Nyar-ai/Robot/MDK-ARM/build_log.txt

*** Using Compiler 'V5.06 update 7 (build 960)', folder: 'D:\kail5\ARM\ARMCC\Bin'
Build target 'Robot'
"Robot\Robot.axf" - 0 Error(s), 0 Warning(s).
Build Time Elapsed:  00:00:01
