Nyar-ai/Robot/Robot.ioc

Mcu.UserName=STM32F407VGTx
PA0-WKUP.Signal=S_TIM2_CH1_ETR
PA1.Signal=S_TIM2_CH2
PA10.Signal=USB_OTG_FS_ID
PA11.Signal=USB_OTG_FS_DM
PA12.Signal=USB_OTG_FS_DP
PA13.Signal=SYS_JTMS-SWDIO
PA14.Signal=SYS_JTCK-SWCLK
PA15.Signal=SYS_JTDI
PA2.Signal=S_TIM2_CH3
PA3.Signal=S_TIM2_CH4
PA6.Signal=S_TIM3_CH1
PA9.Signal=USB_OTG_FS_VBUS
PB10.Signal=USART3_TX
PB11.Signal=USART3_RX
PB3.Signal=SYS_JTDO-SWO
PB5.Signal=GPIO_Output
PB6.Signal=USART1_TX
PB7.Signal=USART1_RX
PB8.Signal=I2C1_SCL
PB9.Signal=I2C1_SDA
PC6.Signal=USART6_TX
PC7.Signal=USART6_RX
PC8.Signal=S_TIM8_CH3
PD12.Signal=S_TIM4_CH1
PD4.Signal=GPIO_Output
PD5.Signal=USART2_TX
PD6.Signal=USART2_RX
PD7.Signal=GPIO_Output
PE12.Signal=GPIO_Output
PE13.Signal=GPIO_Output
PE14.Signal=S_TIM1_CH4
PE15.Signal=GPIO_Output
PE5.Signal=S_TIM9_CH1
PH0-OSC_IN.Signal=RCC_OSC_IN
PH1-OSC_OUT.Signal=RCC_OSC_OUT
