Nyar-ai/Robot/MDK-ARM/.eide/eide.yml

version: "4.1"
name: Robot
type: ARM
deviceName: null
packDir: null
srcDirs: []
virtualFolder:
  name: <virtual_root>
  files: []
  folders:
    - name: Application
      files: []
      folders:
        - name: MDK-ARM
          files:
            - path: startup_stm32f407xx.s
          folders: []
        - name: User
          files: []
          folders:
            - name: Core
              files:
                - path: ../Core/Src/main.c
                - path: ../Core/Src/gpio.c
                - path: ../Core/Src/freertos.c
                - path: ../Core/Src/i2c.c
                - path: ../Core/Src/tim.c
                - path: ../Core/Src/usart.c
                - path: ../Core/Src/usb_otg.c
                - path: ../Core/Src/stm32f4xx_it.c
                - path: ../Core/Src/stm32f4xx_hal_msp.c
                - path: ../Core/Src/stm32f4xx_hal_timebase_tim.c
                - path: ../Core/Src/trape.c
                - path: ../Core/Src/mecanum.c
                - path: ../Core/Src/chassis.c
                - path: ../Core/Src/stepper.c
                - path: ../Core/Src/dma.c
                - path: ../Core/Src/mpu6050.c
                - path: ../Core/Src/system_stm32f4xx.c
                - path: ../Core/Src/camera_align.c
                - path: ../Core/Src/clamp.c
                - path: ../Core/Src/servo.c
                - path: ../Core/Src/camera_color.c
                - path: ../Core/Src/cross_detect.c
              folders: []
    - name: Drivers
      files: []
      folders:
        - name: STM32F4xx_HAL_Driver
          files:
            - path: ../Drivers/STM32F4xx_HAL_Driver/Src/stm32f4xx_hal_tim.c
            - path: ../Drivers/STM32F4xx_HAL_Driver/Src/stm32f4xx_hal_tim_ex.c
            - path: ../Drivers/STM32F4xx_HAL_Driver/Src/stm32f4xx_hal_rcc.c
            - path: ../Drivers/STM32F4xx_HAL_Driver/Src/stm32f4xx_hal_rcc_ex.c
            - path: ../Drivers/STM32F4xx_HAL_Driver/Src/stm32f4xx_hal_flash.c
            - path: ../Drivers/STM32F4xx_HAL_Driver/Src/stm32f4xx_hal_flash_ex.c
            - path: ../Drivers/STM32F4xx_HAL_Driver/Src/stm32f4xx_hal_flash_ramfunc.c
            - path: ../Drivers/STM32F4xx_HAL_Driver/Src/stm32f4xx_hal_gpio.c
            - path: ../Drivers/STM32F4xx_HAL_Driver/Src/stm32f4xx_hal_dma_ex.c
            - path: ../Drivers/STM32F4xx_HAL_Driver/Src/stm32f4xx_hal_dma.c
            - path: ../Drivers/STM32F4xx_HAL_Driver/Src/stm32f4xx_hal_pwr.c
            - path: ../Drivers/STM32F4xx_HAL_Driver/Src/stm32f4xx_hal_pwr_ex.c
            - path: ../Drivers/STM32F4xx_HAL_Driver/Src/stm32f4xx_hal_cortex.c
            - path: ../Drivers/STM32F4xx_HAL_Driver/Src/stm32f4xx_hal.c
            - path: ../Drivers/STM32F4xx_HAL_Driver/Src/stm32f4xx_hal_exti.c
            - path: ../Drivers/STM32F4xx_HAL_Driver/Src/stm32f4xx_hal_i2c.c
            - path: ../Drivers/STM32F4xx_HAL_Driver/Src/stm32f4xx_hal_i2c_ex.c
            - path: ../Drivers/STM32F4xx_HAL_Driver/Src/stm32f4xx_hal_uart.c
          folders: []
        - name: CMSIS
          files:
            - path: ../Core/Src/system_stm32f4xx.c
          folders: []
    - name: Middlewares
      files: []
      folders:
        - name: FreeRTOS
          files:
            - path: ../Middlewares/Third_Party/FreeRTOS/Source/croutine.c
            - path: ../Middlewares/Third_Party/FreeRTOS/Source/event_groups.c
            - path: ../Middlewares/Third_Party/FreeRTOS/Source/list.c
            - path: ../Middlewares/Third_Party/FreeRTOS/Source/queue.c
            - path: ../Middlewares/Third_Party/FreeRTOS/Source/stream_buffer.c
            - path: ../Middlewares/Third_Party/FreeRTOS/Source/tasks.c
            - path: ../Middlewares/Third_Party/FreeRTOS/Source/timers.c
            - path: ../Middlewares/Third_Party/FreeRTOS/Source/CMSIS_RTOS_V2/cmsis_os2.c
            - path: ../Middlewares/Third_Party/FreeRTOS/Source/portable/MemMang/heap_4.c
            - path: ../Middlewares/Third_Party/FreeRTOS/Source/portable/RVDS/ARM_CM4F/port.c
          folders: []
dependenceList: []
outDir: build
miscInfo:
  uid: e0cc28da6c254d071c60158790d19ba3
targets:
  Robot:
    cppPreprocessAttrs:
      defineList:
        - USE_HAL_DRIVER
        - STM32F407xx
      incList:
        - ../Core/Inc
        - ../Drivers/STM32F4xx_HAL_Driver/Inc
        - ../Drivers/STM32F4xx_HAL_Driver/Inc/Legacy
        - ../Middlewares/Third_Party/FreeRTOS/Source/include
        - ../Middlewares/Third_Party/FreeRTOS/Source/CMSIS_RTOS_V2
        - ../Middlewares/Third_Party/FreeRTOS/Source/portable/RVDS/ARM_CM4F
        - ../Drivers/CMSIS/Device/ST/STM32F4xx/Include
        - ../Drivers/CMSIS/Include
        - .cmsis/include
        - RTE/_Robot
      libList: []
    excludeList: []
    settings:
      debugger: cortex-debug
    toolchain: AC5
    toolchainConfigMap:
      AC5:
        archExtensions: ""
        cpuType: Cortex-M4
        floatingPointHardware: single
        options:
          version: 4
          afterBuildTasks: []
          asm-compiler:
            defines: []
          beforeBuildTasks: []
          c/cpp-compiler:
            CXX_FLAGS: --diag_suppress=1 --diag_suppress=1295
            C_FLAGS: --diag_suppress=1 --diag_suppress=1295
            c99-mode: true
            one-elf-section-per-function: true
            optimization: level-3
            warnings: all-warnings
          global:
            output-debug-info: enable
            use-microLIB: false
          linker:
            $outputTaskExcludes:
              - .bin
            output-format: elf
            ro-base: ""
            rw-base: ""
            xo-base: ""
        scatterFilePath: ""
        storageLayout:
          RAM:
            - id: 1
              isChecked: false
              mem:
                size: "0x0"
                startAddr: "0x0"
              noInit: false
              tag: RAM
            - id: 2
              isChecked: false
              mem:
                size: "0x0"
                startAddr: "0x0"
              noInit: false
              tag: RAM
            - id: 3
              isChecked: false
              mem:
                size: "0x0"
                startAddr: "0x0"
              noInit: false
              tag: RAM
            - id: 1
              isChecked: true
              mem:
                size: "0x1C000"
                startAddr: "0x20000000"
              noInit: false
              tag: IRAM
            - id: 2
              isChecked: true
              mem:
                size: "0x4000"
                startAddr: "0x2001C000"
              noInit: false
              tag: IRAM
          ROM:
            - id: 1
              isChecked: false
              isStartup: false
              mem:
                size: "0x0"
                startAddr: "0x0"
              tag: ROM
            - id: 2
              isChecked: false
              isStartup: false
              mem:
                size: "0x0"
                startAddr: "0x0"
              tag: ROM
            - id: 3
              isChecked: false
              isStartup: false
              mem:
                size: "0x0"
                startAddr: "0x0"
              tag: ROM
            - id: 1
              isChecked: true
              isStartup: true
              mem:
                size: "0x100000"
                startAddr: "0x08000000"
              tag: IROM
            - id: 2
              isChecked: true
              isStartup: false
              mem:
                size: "0x0"
                startAddr: "0x0"
              tag: IROM
        useCustomScatterFile: false
      AC6:
        archExtensions: ""
        cpuType: Cortex-M4
        floatingPointHardware: single
        options: ""
        scatterFilePath: <YOUR_SCATTER_FILE>.sct
        storageLayout:
          RAM:
            - id: 1
              isChecked: true
              mem:
                size: "0x5000"
                startAddr: "0x20000000"
              noInit: false
              tag: IRAM
          ROM:
            - id: 1
              isChecked: true
              isStartup: true
              mem:
                size: "0x10000"
                startAddr: "0x08000000"
              tag: IROM
        useCustomScatterFile: false
    uploadConfigMap:
      JLink:
        baseAddr: ""
        bin: ""
        cpuInfo:
          cpuName: "null"
          vendor: "null"
        otherCmds: ""
        proType: 1
        speed: 8000
      STLink:
        address: "0x08000000"
        bin: ""
        elFile: None
        optionBytes: .eide/robot.st.option.bytes.ini
        otherCmds: ""
        proType: SWD
        resetMode: default
        runAfterProgram: true
        speed: 4000
    uploader: STLink
