Nyar-ai/Robot/Core/Inc/mpu6050.h

/**
 * @file    mpu6050.h
 * @brief   MPU6050 陀螺仪驱动(I2C + DMA 异步读取) + yaw 纯积分
 *
 * 硬件:
 *   - I2C1: PB8=SCL, PB9=SDA, 400kHz, DMA 已配(hdma_i2c1_rx/tx)
 *   - MPU6050 地址: 0x68 (AD0 接地), HAL 8位格式 = 0xD0
 *
 * 姿态方案:
 *   - 纯陀螺积分 yaw = Σ(gyro_z · dt) (MPU6050 加速度计测不了 yaw, 不做互补滤波)
 *   - 上电静止校准零漂(读 N 次取平均)
 *   - 水平贴装(+X 指车头) → 用 GYRO_Z, 符号 +1
 *
 * 与 chassis 对接: gyroTask 周期调 chassis_feed_gyro(yaw_deg)
 */
#ifndef __MPU6050_H
#define __MPU6050_H

#include <stdint.h>
#include <stdbool.h>
#include <stddef.h>

/* ---- 寄存器地址(沿用参考代码 MPU6050_Reg.h) ---- */
#define MPU6050_SMPLRT_DIV      0x19
#define MPU6050_CONFIG          0x1A
#define MPU6050_GYRO_CONFIG     0x1B
#define MPU6050_ACCEL_CONFIG    0x1C

#define MPU6050_ACCEL_XOUT_H    0x3B
#define MPU6050_ACCEL_XOUT_L    0x3C
#define MPU6050_ACCEL_YOUT_H    0x3D
#define MPU6050_ACCEL_YOUT_L    0x3E
#define MPU6050_ACCEL_ZOUT_H    0x3F
#define MPU6050_ACCEL_ZOUT_L    0x40
#define MPU6050_TEMP_OUT_H      0x41
#define MPU6050_TEMP_OUT_L      0x42
#define MPU6050_GYRO_XOUT_H     0x43
#define MPU6050_GYRO_XOUT_L     0x44
#define MPU6050_GYRO_YOUT_H     0x45
#define MPU6050_GYRO_YOUT_L     0x46
#define MPU6050_GYRO_ZOUT_H     0x47
#define MPU6050_GYRO_ZOUT_L     0x48

#define MPU6050_PWR_MGMT_1      0x6B
#define MPU6050_PWR_MGMT_2      0x6C
#define MPU6050_WHO_AM_I        0x75

/* ---- I2C 地址 ---- */
#define MPU6050_ADDR_8BIT       0xD0   /* 7位 0x68 左移1位, HAL 用 8 位格式 */

/* ---- 轴选择(按安装方向) ---- */
/* 水平贴装 +X 指车头: yaw = GYRO_Z, 符号 +1 (逆时针自旋为正) */
#define MPU6050_YAW_USE_AXIS   2       /* 0=X, 1=Y, 2=Z */
#define MPU6050_YAW_SIGN       1.0f    /* 实测若 yaw 递减则改 -1.0f */

/* ---- 量程灵敏度 ---- */
/* GYRO_CONFIG=0x18 → ±2000°/s, 灵敏度 16.4 LSB/(°/s) */
#define MPU6050_GYRO_SENSITIVITY   16.4f

/* ---- 零漂抑制配置(分层策略) ---- */
/* 1) DLPF 降噪 + 1kHz 采样匹配: DLPF_CFG=3→带宽44Hz/延迟4.9ms, 0=关闭(5.1kHz,噪声大) */
#define MPU6050_DLPF_CFG            3
/* 2) 死区: |角速度|<此值视为0, 掐断残余零漂的纯积分(deg/s)
 *   注意: 直线行驶缓慢偏航的角速度通常在 0.05~0.2°/s, 阈值不能过大否则陀螺仪
 *         感知不到微小偏移。0.05°/s ≈ 0.8 LSB(@±2000°/s), 仅过滤电噪声。 */
#define MPU6050_DEADZONE_DPS        0.05f
/* 3) 校准: 预热丢弃样本数 + 采样缓冲上限(静态分配, 避免占栈) */
#define MPU6050_CALIB_WARMUP        200
#define MPU6050_CALIB_BUF           256
/* 4) 运行期自适应零偏跟踪: 仅判"静止"时用大τ一阶低通更新零偏 */
#define MPU6050_BIAS_TRACK_TAU      5.0f    /* 时间常数(s), 越大跟踪越慢越稳 */
/* 5) 静止检测滑窗(@1kHz 时 200 样本=200ms)与判定阈值
 *   注意: 阈值过松会导致直线缓行被误判为"静止"从而触发自适应零偏跟踪,
 *         把真实角速度吸收进零偏估计, 进一步削弱感知。 */
#define MPU6050_STATIC_WINDOW       200
#define MPU6050_STATIC_RATE_THR     0.5f    /* 窗口去偏|均值|阈值(deg/s) */
#define MPU6050_STATIC_VAR_THR      0.3f    /* 窗口方差阈值((deg/s)^2) */
/* 6) 静止自动重校准: 持续静止达到此时长则用窗口均值覆盖零偏(ms) */
#define MPU6050_RECALIB_STATIC_MS   2000
/* 7) 温度补偿: bias(T)=bias0 + k·(T-T_calib), k 标定后填值(LSB/°C), 0=不补偿 */
#define MPU6050_BIAS_TEMP_COEF      0.0f

/* ---- 一次读取的数据块(从 0x3B 起 14 字节) ---- */
typedef struct {
    int16_t accel_x;
    int16_t accel_y;
    int16_t accel_z;
    int16_t temp;
    int16_t gyro_x;
    int16_t gyro_y;
    int16_t gyro_z;
} MPU6050_RawData;

/**
 * @brief 初始化 MPU6050(沿用参考代码寄存器序列)
 * @return 0=成功, 非0=失败(读 WHO_AM_I 不对)
 */
uint8_t MPU6050_Init(void);

/**
 * @brief 上电静止校准 yaw 零漂(读 N 次取平均)
 * @note  调用时车必须静止! 会阻塞约 N×(单次读耗时)
 */
void MPU6050_CalibrateYaw(uint16_t sample_count);

/**
 * @brief 启动一次 DMA 异步读取(非阻塞, 立即返回)
 * @return 0=已启动, 非0=上一次还没读完或出错
 */
uint8_t MPU6050_StartReadDMA(void);

/**
 * @brief DMA 读取是否完成(供 gyroTask 轮询, 或用信号量等待)
 */
bool MPU6050_IsReadComplete(void);

/**
 * @brief 取最近一次 DMA 读到的原始数据(含 6 轴 + 温度)
 */
void MPU6050_GetRaw(MPU6050_RawData *raw);

/**
 * @brief 取当前陀螺 yaw 角速度(deg/s, 已去零漂, 已乘符号)
 */
float MPU6050_GetYawRate(void);

/**
 * @brief 取当前累积的 yaw 角(deg, 已归一到 [-180,180])
 */
float MPU6050_GetYaw(void);

/**
 * @brief yaw 积分一步(由 gyroTask 周期调用)
 * @param dt 步长(秒), 例如 0.001f
 */
void MPU6050_IntegrateYaw(float dt);

/**
 * @brief 强制设置 yaw(用于校准/重置)
 */
void MPU6050_SetYaw(float yaw_deg);

/**
 * @brief DMA 完成回调入口(供 HAL_I2C_MemRxCpltCallback 在中断里调用)
 *        解析 14 字节 → 更新 yaw_rate + 置完成标志
 */
void MPU6050_OnDMAComplete(void);

/**
 * @brief 取当前 MPU6050 片上温度(°C)
 * @note  公式: T = TEMP_OUT/340 + 36.53 (寄存器 0x41/0x42)
 */
float MPU6050_GetTempC(void);

/**
 * @brief 当前是否被判为静止(用于自适应零偏/重校准判断)
 * @return true=近 MPU6050_STATIC_WINDOW 样本被判静止
 */
bool MPU6050_IsStatic(void);

/**
 * @brief 强制立即触发一次静止重校准(覆盖运行期零偏与温度基准)
 * @note  调用时车必须静止; 内部读 MPU6050_STATIC_WINDOW 个样本重算零偏
 */
void MPU6050_ForceRecalibrate(void);

#endif /* __MPU6050_H */
