Nyar-ai/Robot/(commit log)

2026-07-06 更改了EIDE的配置
2026-07-06 修改了通过vscode EIDE打开时的配置错误
2026-07-06 摄像头代码
2026-07-07 测试了 麦克纳姆轮运动学 S 形曲线规划器 底盘控制层 模块
2026-07-08 修复了陀螺仪干扰底盘控制层的潜在问题
2026-07-09 修复了mpu6050.h中的一个警告
2026-07-12 修复了外部晶振错误的问题
2026-07-13 基本解决s形曲线不平滑的问题
2026-07-13 车地盘参数基本调完
2026-07-13 步进电机梯形控制算法
2026-07-14 修复了没有启用步进电机寄存器的自动重装载寄存器的BUG
2026-07-14 在写入定时器重装载寄存器的地方添加了临界区
2026-07-14 更改了车的尺寸
2026-07-14 实际在地面测试后改变了一些参数
2026-07-15 调整参数，提高车的精度
2026-07-15 增加了平移时的PID
2026-07-15 更换了更大的轮子
2026-07-16 统一了车轮的宏定义
2026-07-16 更新了摄像头定位
2026-07-17 增加了十字交叉点纠正（未测试）
2026-07-17 增加了摄像头的测试程序
2026-07-18 改变了摄像头离地面的距离，增加了对地面反光的处理
2026-07-19 重写了摄像头和单片机之间的通讯
2026-07-19 更新了摄像头的算法，增加了测试程序
2026-07-19 改回原来的算法
2026-07-19 修复了一个问题
2026-07-19 在摄像头中增加了ROI兴趣区域，防止拍到车位
2026-07-20 实地测量后更改了摄像头的参数
2026-07-20 对摄像头的串口号进行了调整从2变3
2026-07-20 把测试程序同步到上车的摄像头程序，准备实测
2026-07-21 成功和单片机通讯
2026-07-22 开始写任务
2026-07-23 写了ACE任务
2026-07-26 增加了夹具旋转夹取需要的舵机
2026-07-26 调整了灰度，使摄像头在室内灯光环境下更好识别黑色十字，对底盘运动学进行调参，启用了积分项，使车走的更直
2026-07-28 更改了陀螺仪的参数，使得纠偏变得更加敏锐
2026-07-29 修复了夹具和运动方面的bug
2026-07-29 fix: prevent servo re-initialization and enable TIM1 preload
    [Robot.ioc, servo.c]
2026-07-29 杂事：移除未使用的chassis_theta_deg，给头文件添加换行
    删除了不再使用的静态chassis_theta_deg辅助函数，减小了代码大小。为头文件添加了缺失的尾部换行符以符合POSIX规范。
2026-07-30 修复：调整夹具零角度并禁用默认任务自动运行
    - 将 CLAMP_ROTATE_ZERO_DEG 从 128 改为 75 以纠正物理零偏差
    - 定义 CLAMP_GRIPPER_OPEN_DEG（180）和 CLAMP_GRIPPER_CLOSE_DEG（0）以便清楚说明
    - 用常量替换夹爪开/关和伺服初始化中的硬编码角度
    - 将默认任务初始状态设置为 DS_DONE，防止启动时意外动作
    [clamp.c, clamp.h, servo.c]
2026-07-30 feat(clamp): 添加 go_up/go_down 测试并交换夹爪开/关角度
    - 将 CLAMP_GRIPPER_OPEN_DEG 从 180 改为 90，CLOSE_DEG 从 0 改为 180，以匹配实际夹爪范围
    - 在 defaultTask 中添加夹爪开/关测试序列
    - 使用 GO_UP 和 GO_DOWN 状态扩展状态机，以通过 clamp_set_height(80.0f) 验证高度控制
    - 对 freertos.c 进行了小幅代码格式和对齐调整
2026-07-30 重构：为了清楚起见，把Scurve规划器重命名为Trape
2026-07-31 添加了前置摄像头的颜色识别功能（未测试）
2026-07-31 修改：为颜色识别增加了黑白两种颜色
2026-07-31 合并后的一次提交
2026-07-31 重写了readme
2026-08-02 重构（clamp, servo）：更新颜色映射和夹爪角度 在 camera_color 模块中将颜色索引2从黄色改为绿色 将夹爪角度定义更新为60°张开和90°闭合 将夹爪舵机范围从0-180°扩展至0-270° 修正注释和文档，以反映新的夹爪范围及颜色映射
    [camera_color.h, clamp.h, main.py, servo.h]
2026-08-02 重构(freertos)：简化默认任务并调整夹爪张开角度
    移除 StartDefaultTask 中的测试代码和自动循环代码，替换为 taskflow 逻辑。添加 taskflow.h 头文件包含。将夹爪张开角度从 60 度调整为 50 度。
